JRLipina/PowerBoard-Hardware/2015/Hardware/PT_2015_PB_MAIN_Rev2_Panelization.brd

## EAGLE design 2015/Hardware/PT_2015_PB_MAIN_Rev2_Panelization.brd (2015-01-30)

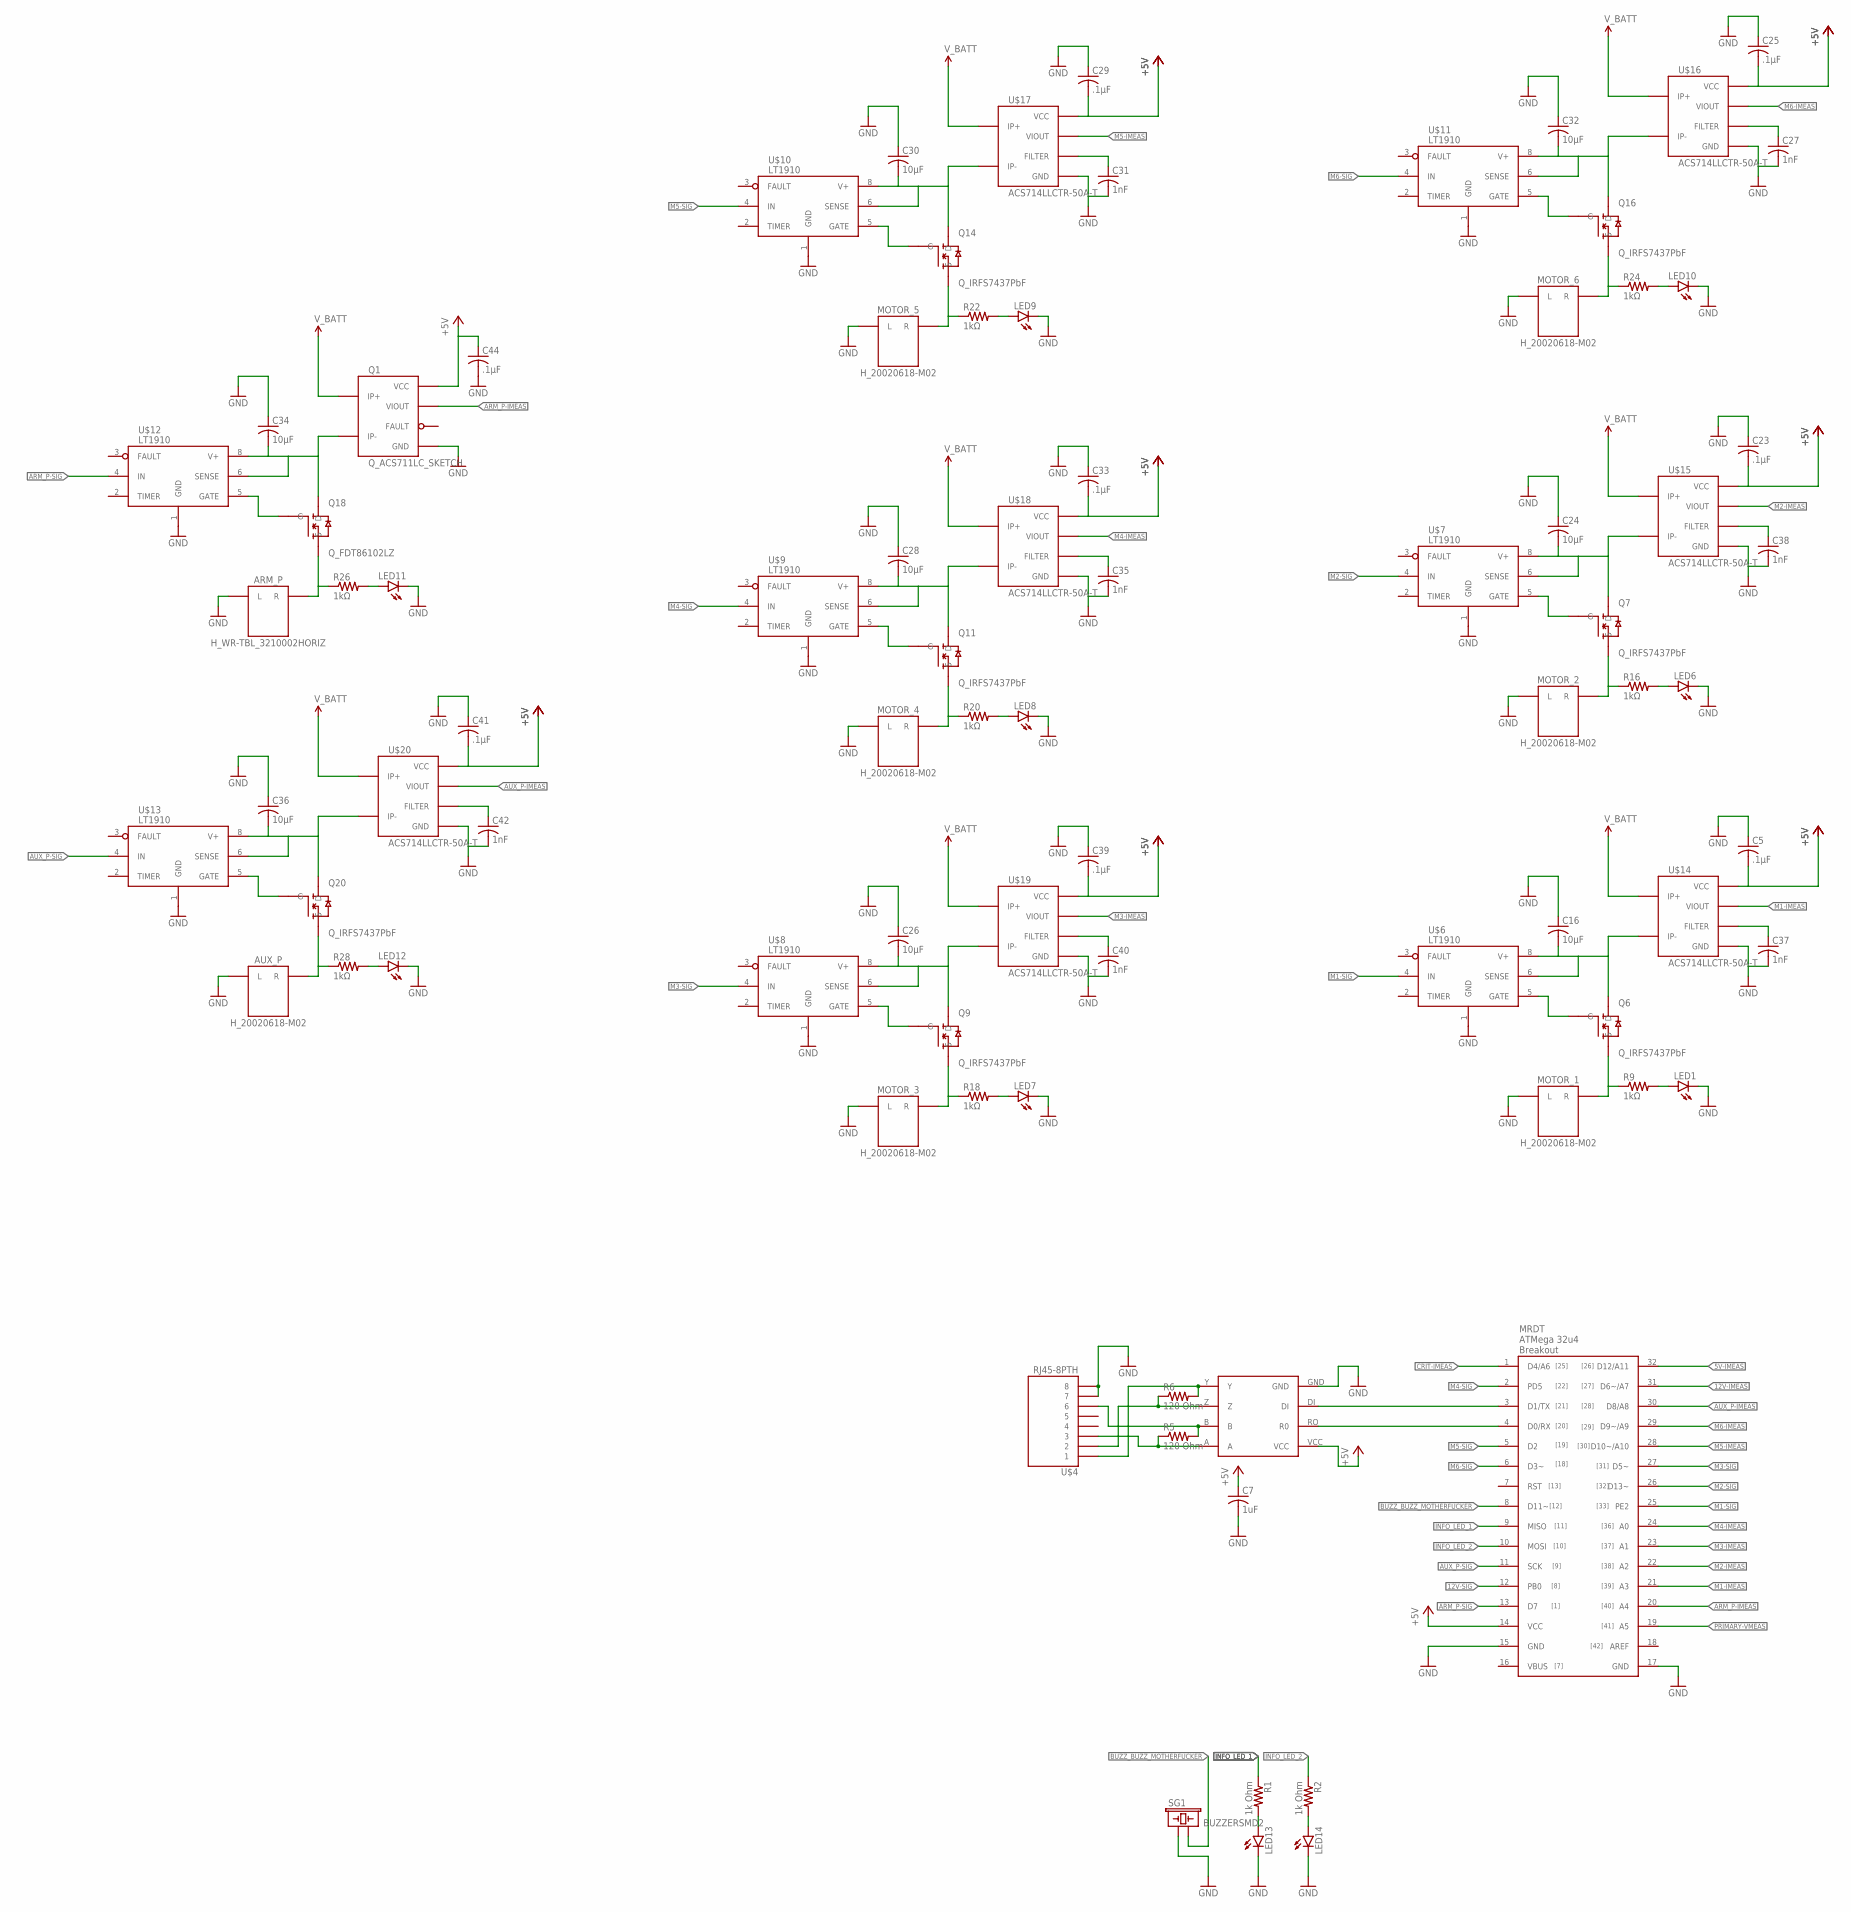
[picture p1: schematic PT_2015_PB_MAIN_Rev2_Panelization.sch, sheet 1, part in row 1, column 1]

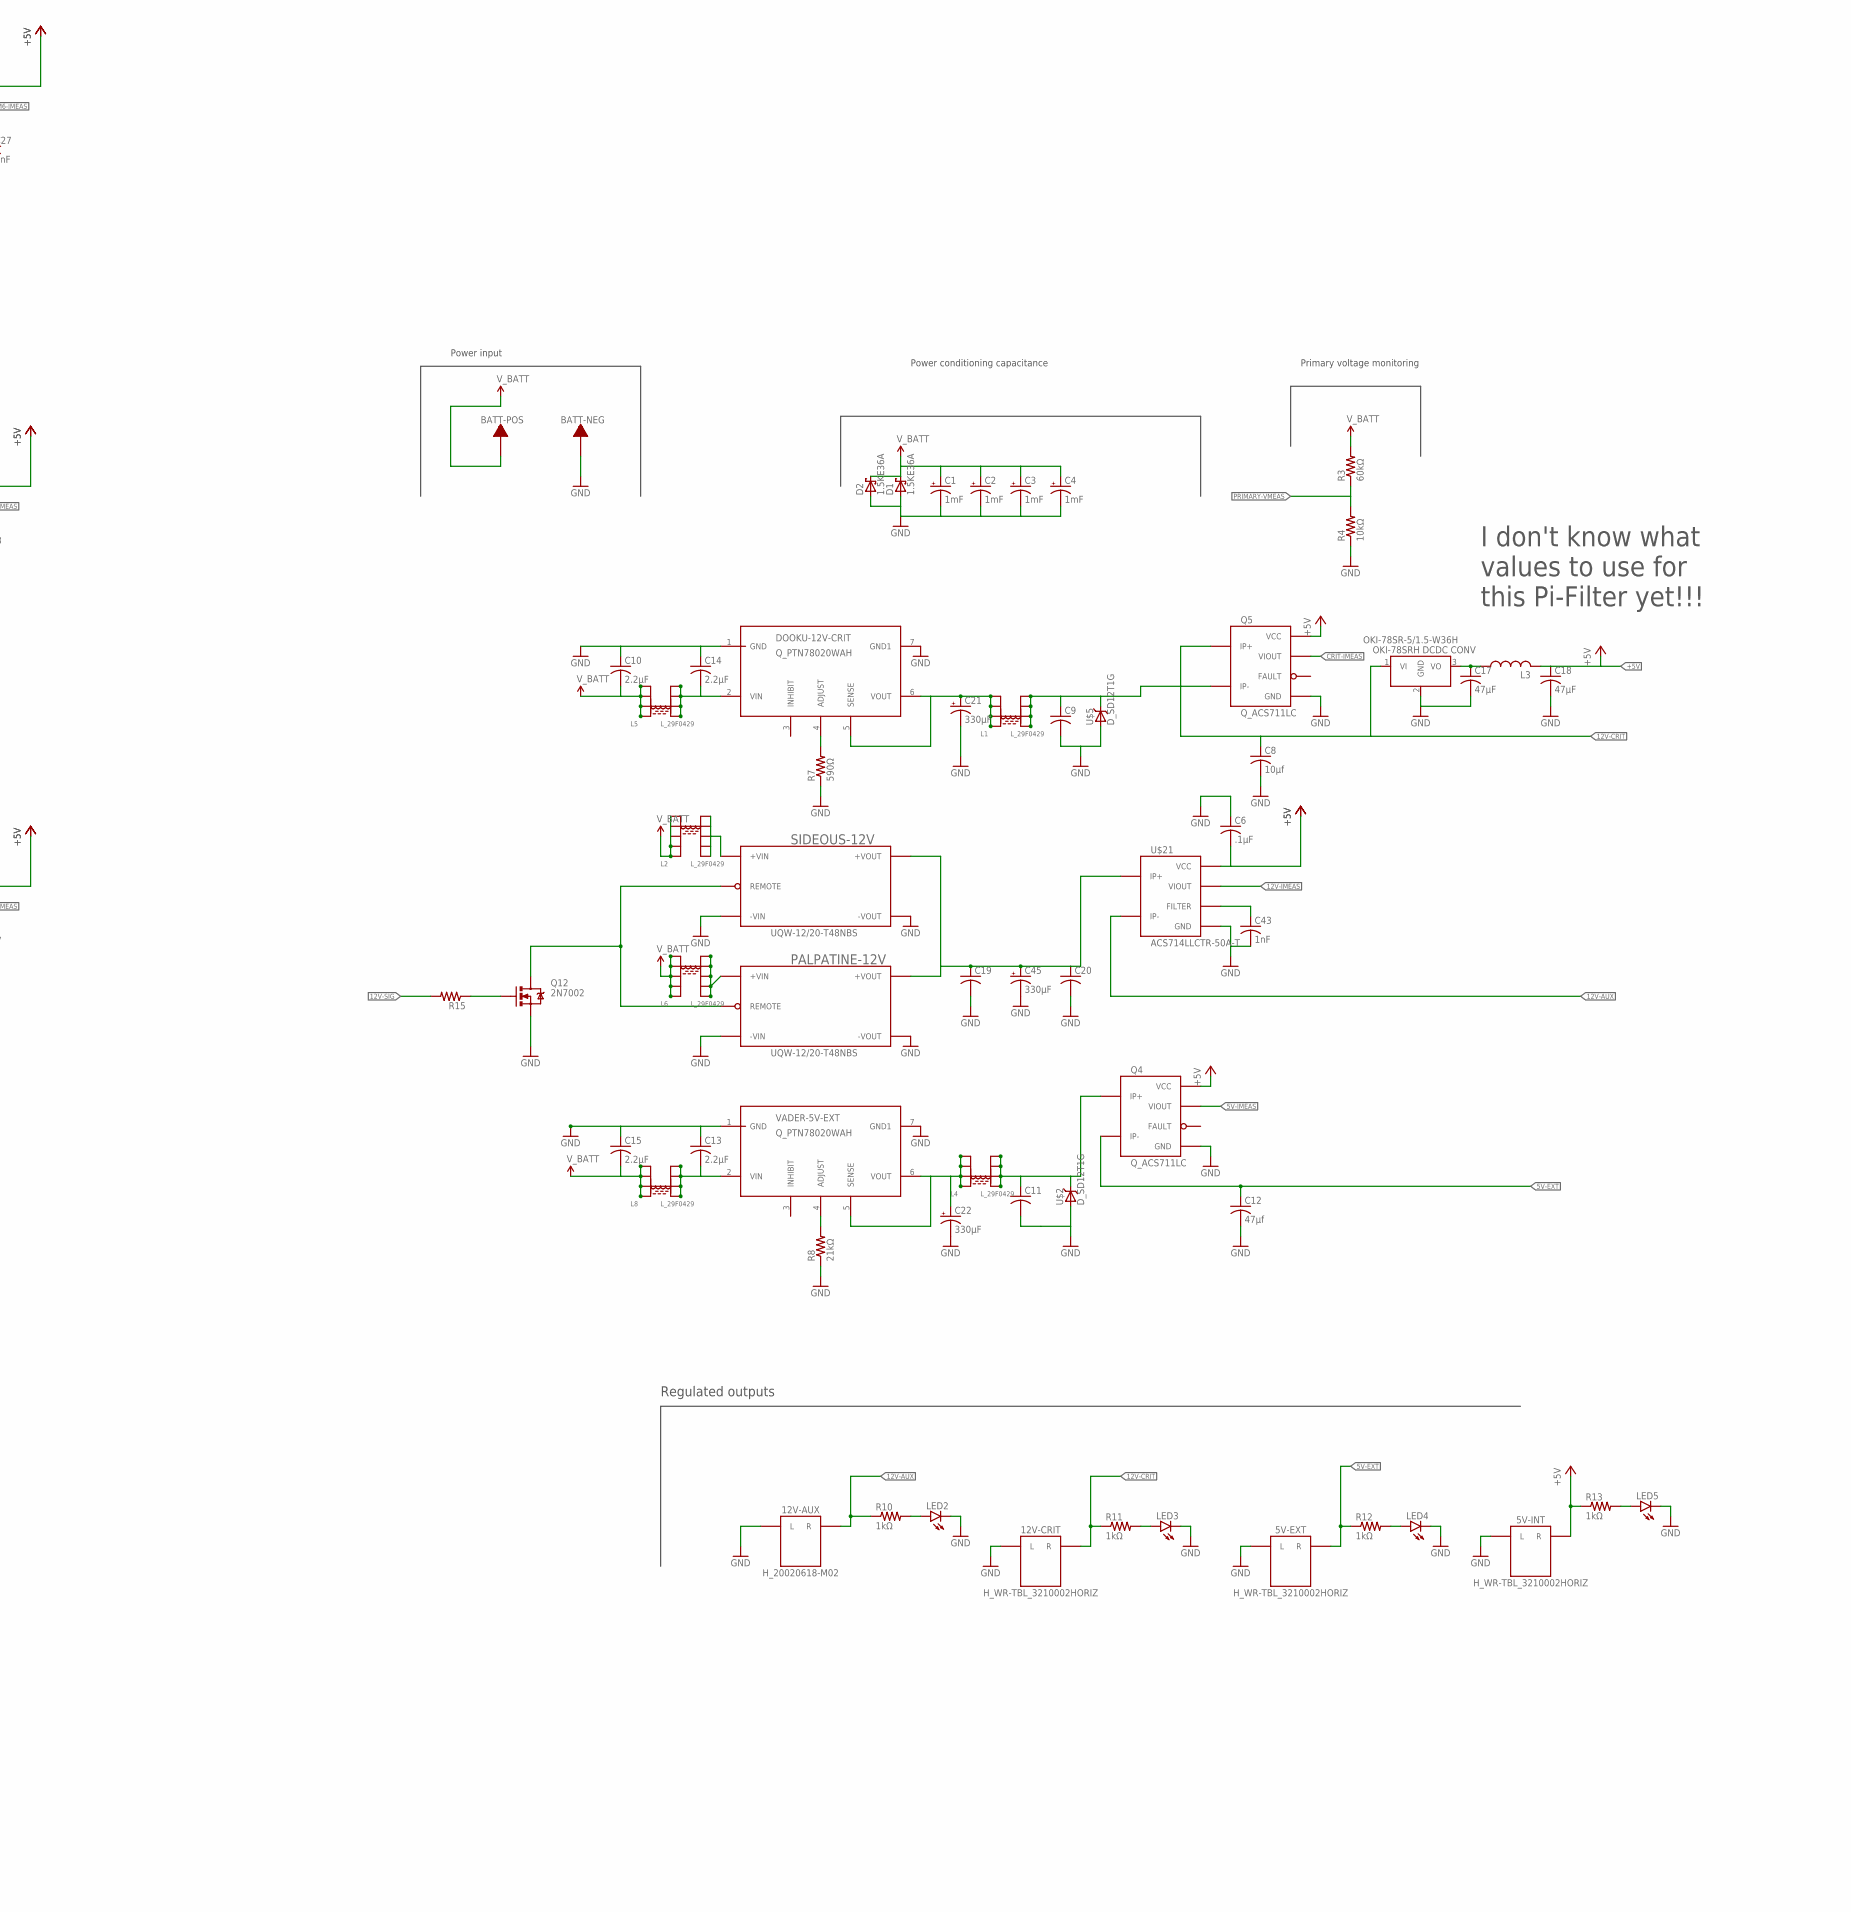
[picture p2: schematic PT_2015_PB_MAIN_Rev2_Panelization.sch, sheet 1, part in row 1, column 2]

Parts:
5V-EXT, 5V-INT, 12V-CRIT: H_WR-TBL_3210002HORIZ; 691322110002
12V-AUX: H_20020618-M02; 20020618-M02
ARM_P: H_WR-TBL_3210002HORIZ; 691322110002
AUX_P: H_20020618-M02; 20020618-M02
BATT-NEG: TERMINAL_HOLE; LARGE_TERMINAL_HOLE
BATT-POS: TERMINAL_HOLE; LARGE_TERMINAL_HOLE
C1, C2, C3, C4: 1mF; C_12.5MM
C5, C6, C23, C25, C29, C33, C39, C41, C44: .1µF; C1206
C7: 1uF; C1206
C8: 10µf; C1206
C9, C11, C19, C20: C-USC1206; C1206
C10, C13, C14, C15: 2.2µF; C1206
C12: 47µf; C1206
C16, C24, C26, C28, C30, C32, C34, C36: 10µF; C1206
C17, C18: 47µF; C1206
C21, C22, C45: 330µF; E5-8,5
C27, C31, C35, C37, C38, C40, C42, C43: 1nF; C0805
D1, D2: 1.5KE36A; CB429-17
DOOKU-12V-CRIT: Q_PTN78020WAH; R_PDSS-T7
L1, L4, L5, L8: L_29F0429
L2, L6: L_29F0429; L_29F0528
L3: L-USL4532C; L4532M
LED1, LED2, LED3, LED4, LED5, LED6, LED7, LED8, LED9, LED10, LED11, LED12: LED1206; LED-1206
LED13, LED14: LED-FKIT-1206; FKIT-LED-1206
MOTOR_1, MOTOR_2, MOTOR_3, MOTOR_4, MOTOR_5, MOTOR_6: H_20020618-M02; 20020618-M02
OKI-78SR-5/1.5-W36H: Q_OKI-78SR; OKI-78SRH
PALPATINE-12V: UQW-12/20-T48NBS; U-T48-QB-NO_TRIM
Q1: Q_ACS711LC_SKETCH; SOIC8_ACS711_SKETCH
Q4, Q5: Q_ACS711LC; SOIC8_ACS711
Q6, Q7, Q9, Q11, Q14, Q16, Q20: Q_IRFS7437PbF; D2PACK
Q12: 2N7002; SOT323
Q18: Q_FDT86102LZ; SOT-223
R1, R2: 1k Ohm; 1206
R3: 60kΩ; R1206
R4: 10kΩ; R1206
R5, R6: 120 Ohm; 1206
R7: 590Ω; R1206
R8: 21kΩ; R1206
R9, R10, R11, R12, R13, R16, R18, R20, R22, R24, R26, R28: 1kΩ; 1206
R15: R-US_R1206; R1206
SG1: BUZZERSMD2; BUZZER-CCV
SIDEOUS-12V: UQW-12/20-T48NBS; U-T48-QB-NO_TRIM
U$1: 32U4_BREAKOUT; 32U4_MCU_DIP
U$2, U$5: D_SD12T1G; SOD-323
U$3: MAX3077; MAX3070E
U$4: RJ45-8PTH; RJ45-8
U$6, U$7, U$8, U$9, U$10, U$11, U$12, U$13: LT1910; SO8
U$14, U$15, U$16, U$17, U$18, U$19, U$20: ACS714LLCTR-50A-T; SOIC8_ACS711_SKETCH
U$21: ACS714LLCTR-50A-T; SOIC8_ACS711
VADER-5V-EXT: Q_PTN78020WAH; R_PDSS-T7

Connections:
0: 5V-EXT.L, 5V-INT.L, 12V-AUX.L1 (L), 12V-AUX.L2 (L), 12V-CRIT.L, ARM_P.L, AUX_P.L1 (L), AUX_P.L2 (L), BATT-NEG.P$1, C1.-, C2.-, C3.-, C4.-, C5.1, C6.1, C7.2, C8.2, C9.2, C10.1, C11.2, C12.2, C13.1, C14.1, C15.1, C16.1, C17.2, C18.2, C19.2, C20.2, C21.-, C22.-, C23.1, C24.1, C25.1, C26.1, C27.2, C28.1, C29.1, C30.1, C31.2, C32.1, C33.1, C34.1, C35.2, C36.1, C37.2, C38.2, C39.1, C40.2, C41.1, C42.2, C43.2, C44.2, C45.-, D1.A, D2.A, DOOKU-12V-CRIT.1 (GND), DOOKU-12V-CRIT.7 (GND1), LED1.C, LED2.C, LED3.C, LED4.C, LED5.C, LED6.C, LED7.C, LED8.C, LED9.C, LED10.C, LED11.C, LED12.C, LED13.C, LED14.C, MOTOR_1.L1 (L), MOTOR_1.L2 (L), MOTOR_2.L1 (L), MOTOR_2.L2 (L), MOTOR_3.L1 (L), MOTOR_3.L2 (L), MOTOR_4.L1 (L), MOTOR_4.L2 (L), MOTOR_5.L1 (L), MOTOR_5.L2 (L), MOTOR_6.L1 (L), MOTOR_6.L2 (L), OKI-78SR-5/1.5-W36H.2 (GND), PALPATINE-12V.3 (-VIN), PALPATINE-12V.4 (-VOUT), Q1.5 (GND), Q4.5 (GND), Q5.5 (GND), Q12.2 (S), R4.1, R7.1, R8.1, SG1.+ (1), SIDEOUS-12V.3 (-VIN), SIDEOUS-12V.4 (-VOUT), U$1.15 (GND), U$1.17 (GND), U$2.2 (A), U$3.GND, U$4.7, U$4.8, U$5.2 (A), U$6.1 (GND), U$7.1 (GND), U$8.1 (GND), U$9.1 (GND), U$10.1 (GND), U$11.1 (GND), U$12.1 (GND), U$13.1 (GND), U$14.5 (GND), U$15.5 (GND), U$16.5 (GND), U$17.5 (GND), U$18.5 (GND), U$19.5 (GND), U$20.5 (GND), U$21.5 (GND), VADER-5V-EXT.1 (GND), VADER-5V-EXT.7 (GND1)
5V-EXT: 5V-EXT.R, C12.1, Q4.4 (IP-), R12.1
5V-IMEAS: Q4.7 (VIOUT), U$1.32 (D12/A11)
12V-AUX: 12V-AUX.R1 (R), 12V-AUX.R2 (R), R10.1, U$21.4 (IP-)
12V-CRIT: 12V-CRIT.R, C8.1, OKI-78SR-5/1.5-W36H.1 (VI), Q5.1 (IP+), R11.1
12V-IMEAS: U$1.31 (D6~/A7), U$21.7 (VIOUT)
12V-SIG: R15.2, U$1.12 (PB0)
+5V: 5V-INT.R, C5.2, C6.2, C7.1, C18.1, C23.2, C25.2, C29.2, C33.2, C39.2, C41.2, C44.1, L3.2, Q1.8 (VCC), Q4.8 (VCC), Q5.8 (VCC), R13.1, U$1.14 (VCC), U$3.VCC, U$14.8 (VCC), U$15.8 (VCC), U$16.8 (VCC), U$17.8 (VCC), U$18.8 (VCC), U$19.8 (VCC), U$20.8 (VCC), U$21.8 (VCC)
ARM_P-IMEAS: Q1.7 (VIOUT), U$1.20 (A4)
ARM_P-SIG: U$1.13 (D7), U$12.4 (IN)
AUX_P-IMEAS: U$1.30 (D8/A8), U$20.7 (VIOUT)
AUX_P-SIG: U$1.11 (SCK), U$13.4 (IN)
BUZZ_BUZZ_MOTHERFUCKER: SG1.- (2), U$1.8 (D11~)
CRIT-IMEAS: Q5.7 (VIOUT), U$1.1 (D4/A6)
INFO_LED_1: R1.1, U$1.9 (MISO)
INFO_LED_2: R2.1, U$1.10 (MOSI)
M1-IMEAS: U$1.21 (A3), U$14.7 (VIOUT)
M1-SIG: U$1.25 (PE2), U$6.4 (IN)
M2-IMEAS: U$1.22 (A2), U$15.7 (VIOUT)
M2-SIG: U$1.26 (D13~), U$7.4 (IN)
M3-IMEAS: U$1.23 (A1), U$19.7 (VIOUT)
M3-SIG: U$1.27 (D5~), U$8.4 (IN)
M4-IMEAS: U$1.24 (A0), U$18.7 (VIOUT)
M4-SIG: U$1.2 (PD5), U$9.4 (IN)
M5-IMEAS: U$1.28 (D10~/A10), U$17.7 (VIOUT)
M5-SIG: U$1.5 (D2), U$10.4 (IN)
M6-IMEAS: U$1.29 (D9~/A9), U$16.7 (VIOUT)
M6-SIG: U$1.6 (D3~), U$11.4 (IN)
unnamed: C37.1, U$14.6 (FILTER)
unnamed: C38.1, U$15.6 (FILTER)
unnamed: C13.2, L8.5, L8.6, L8.7, L8.8, VADER-5V-EXT.2 (VIN)
unnamed: PALPATINE-12V.2 (REMOTE), Q12.3 (D), SIDEOUS-12V.2 (REMOTE)
unnamed: L6.6, L6.7, L6.8, L6.9, L6.10, PALPATINE-12V.1 (+VIN)
unnamed: L2.6, L2.7, L2.8, L2.9, L2.10, SIDEOUS-12V.1 (+VIN)
unnamed: C19.1, C20.1, C45.+, PALPATINE-12V.8 (+VOUT), SIDEOUS-12V.8 (+VOUT), U$21.1 (IP+)
unnamed: C14.2, DOOKU-12V-CRIT.2 (VIN), L5.5, L5.6, L5.7, L5.8
unnamed: DOOKU-12V-CRIT.4 (ADJUST), R7.2
unnamed: C9.1, L1.5, L1.6, L1.7, L1.8, Q5.4 (IP-), U$5.1 (C)
unnamed: LED13.A, R1.2
unnamed: C43.1, U$21.6 (FILTER)
unnamed: R6.2, U$3.Y, U$4.1
unnamed: C22.+, L4.1, L4.2, L4.3, L4.4, VADER-5V-EXT.5 (SENSE), VADER-5V-EXT.6 (VOUT)
unnamed: C11.1, L4.5, L4.6, L4.7, L4.8, Q4.1 (IP+), U$2.1 (C)
unnamed: C27.1, U$16.6 (FILTER)
unnamed: R6.1, U$3.Z, U$4.2
unnamed: R5.2, U$3.B, U$4.6
unnamed: R5.1, U$3.A, U$4.3
unnamed: U$1.3 (D1/TX), U$3.DI
unnamed: C31.1, U$17.6 (FILTER)
unnamed: C35.1, U$18.6 (FILTER)
unnamed: C40.1, U$19.6 (FILTER)
unnamed: C42.1, U$20.6 (FILTER)
unnamed: C24.2, Q7.TAB (D), U$7.6 (SENSE), U$7.8 (V+), U$15.4 (IP-)
unnamed: MOTOR_2.R1 (R), MOTOR_2.R2 (R), Q7.2 (S), R16.1
unnamed: Q7.1 (G), U$7.5 (GATE)
unnamed: LED6.A, R16.2
unnamed: LED14.A, R2.2
unnamed: R8.2, VADER-5V-EXT.4 (ADJUST)
unnamed: C21.+, DOOKU-12V-CRIT.5 (SENSE), DOOKU-12V-CRIT.6 (VOUT), L1.1, L1.2, L1.3, L1.4
unnamed: LED1.A, R9.2
unnamed: C16.2, Q6.TAB (D), U$6.6 (SENSE), U$6.8 (V+), U$14.4 (IP-)
unnamed: MOTOR_1.R1 (R), MOTOR_1.R2 (R), Q6.2 (S), R9.1
unnamed: Q6.1 (G), U$6.5 (GATE)
unnamed: C26.2, Q9.TAB (D), U$8.6 (SENSE), U$8.8 (V+), U$19.4 (IP-)
unnamed: MOTOR_3.R1 (R), MOTOR_3.R2 (R), Q9.2 (S), R18.1
unnamed: LED2.A, R10.2
unnamed: Q9.1 (G), U$8.5 (GATE)
unnamed: LED3.A, R11.2
unnamed: LED7.A, R18.2
unnamed: LED4.A, R12.2
unnamed: LED5.A, R13.2
unnamed: C28.2, Q11.TAB (D), U$9.6 (SENSE), U$9.8 (V+), U$18.4 (IP-)
unnamed: MOTOR_4.R1 (R), MOTOR_4.R2 (R), Q11.2 (S), R20.1
unnamed: Q11.1 (G), U$9.5 (GATE)
unnamed: LED8.A, R20.2
unnamed: C30.2, Q14.TAB (D), U$10.6 (SENSE), U$10.8 (V+), U$17.4 (IP-)
unnamed: MOTOR_5.R1 (R), MOTOR_5.R2 (R), Q14.2 (S), R22.1
unnamed: Q14.1 (G), U$10.5 (GATE)
unnamed: LED9.A, R22.2
unnamed: C32.2, Q16.TAB (D), U$11.6 (SENSE), U$11.8 (V+), U$16.4 (IP-)
unnamed: MOTOR_6.R1 (R), MOTOR_6.R2 (R), Q16.2 (S), R24.1
unnamed: Q16.1 (G), U$11.5 (GATE)
unnamed: LED10.A, R24.2
unnamed: C34.2, Q1.4 (IP-), Q18.2 (D), Q18.4 (D), U$12.6 (SENSE), U$12.8 (V+)
unnamed: ARM_P.R, Q18.3 (S), R26.1
unnamed: Q18.1 (G), U$12.5 (GATE)
unnamed: LED11.A, R26.2
unnamed: C36.2, Q20.TAB (D), U$13.6 (SENSE), U$13.8 (V+), U$20.4 (IP-)
unnamed: AUX_P.R1 (R), AUX_P.R2 (R), Q20.2 (S), R28.1
unnamed: Q20.1 (G), U$13.5 (GATE)
unnamed: LED12.A, R28.2
unnamed: C17.1, L3.1, OKI-78SR-5/1.5-W36H.3 (VO)
unnamed: Q12.1 (G), R15.1
PRIMARY-VMEAS: R3.1, R4.2, U$1.19 (A5)
RXD: U$1.4 (D0/RX), U$3.RO (R0)
V_BATT: BATT-POS.P$1, C1.+, C2.+, C3.+, C4.+, C10.2, C15.2, D1.C, D2.C, L2.1, L2.2, L2.3, L2.4, L2.5, L5.1, L5.2, L5.3, L5.4, L6.1, L6.2, L6.3, L6.4, L6.5, L8.1, L8.2, L8.3, L8.4, Q1.1 (IP+), R3.2, U$14.1 (IP+), U$15.1 (IP+), U$16.1 (IP+), U$17.1 (IP+), U$18.1 (IP+), U$19.1 (IP+), U$20.1 (IP+)

Notes on the sheet:
Primary voltage monitoring
Power conditioning capacitance
Power input
I don't know what values to use for this Pi-Filter yet!!!
Regulated outputs

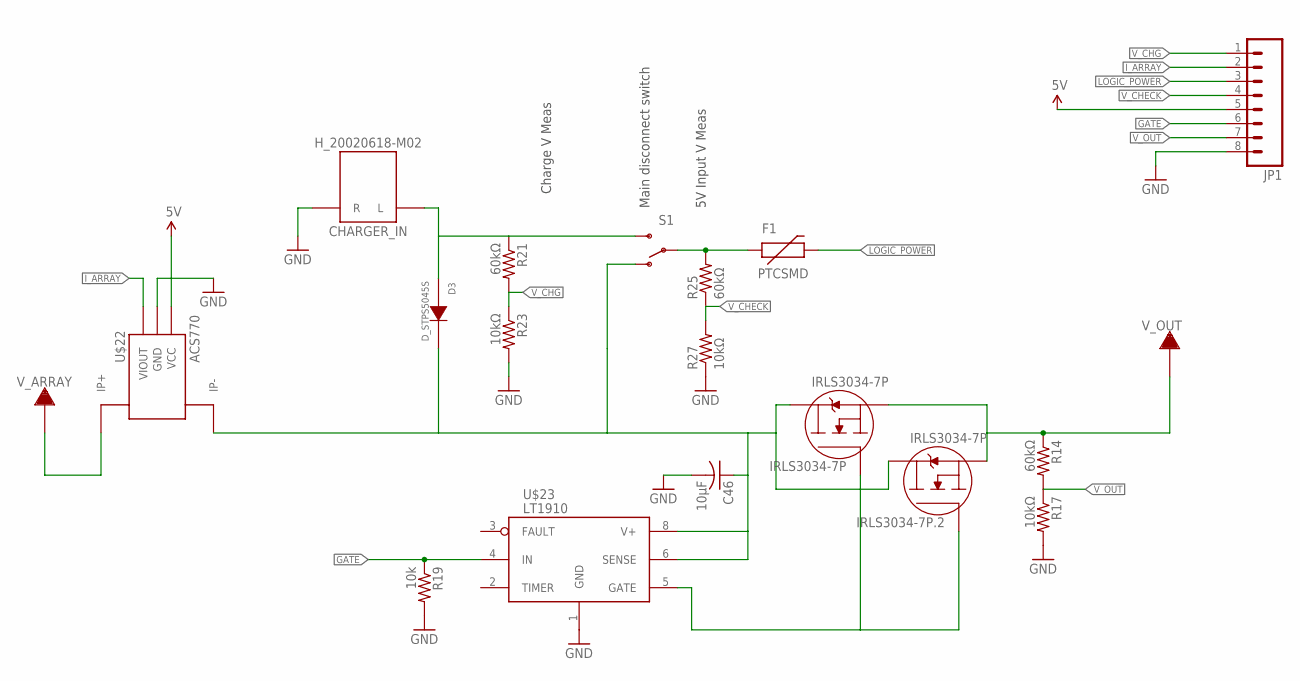
[picture p3: schematic PT_2015_PB_MAIN_Rev2_Panelization.sch, sheet 2]

Parts:
C46: 10µF; C1206
CHARGER_IN: H_20020618-M02; 20020618-M02
D3: D_STPS5045S; D2PACK
F1: PTCSMD; PTC-1206
IRLS3034-7P, IRLS3034-7P.2: IRLS3034-7P; D2PAK-7
JP1: M08BM08B-SRSS-TB; BM08B-SRSS-TB
R14, R21, R25: 60kΩ; R1206
R17, R23, R27: 10kΩ; R1206
R19: 10k; R1206
S1: SWITCH-SPDTPTH; SWITCH-SPDT
U$22: ACS770; PFF_LEADFORM
U$23: LT1910; SO8
V_ARRAY: TERMINAL_HOLE; LARGE_TERMINAL_HOLE
V_OUT: TERMINAL_HOLE; LARGE_TERMINAL_HOLE

Connections:
5V_SSR: JP1.5, U$22.1 (VCC)
GATE: JP1.6, R19.1, U$23.4 (IN)
GND_SSR: C46.2, CHARGER_IN.R1 (R), CHARGER_IN.R2 (R), JP1.8, R17.2, R19.2, R23.2, R27.1, U$22.2 (GND), U$23.1 (GND)
I_ARRAY: JP1.2, U$22.3 (VIOUT)
LOGIC_POWER: F1.2, JP1.3
unnamed: IRLS3034-7P.2 (SOURCE), IRLS3034-7P.3 (SOURCE), IRLS3034-7P.4 (SOURCE), IRLS3034-7P.5 (SOURCE), IRLS3034-7P.6 (SOURCE), IRLS3034-7P.2.2 (SOURCE), IRLS3034-7P.2.3 (SOURCE), IRLS3034-7P.2.4 (SOURCE), IRLS3034-7P.2.5 (SOURCE), IRLS3034-7P.2.6 (SOURCE), R14.1, V_OUT.P$1
unnamed: IRLS3034-7P.1 (GATE), IRLS3034-7P.2.1 (GATE), U$23.5 (GATE)
unnamed: U$22.4_1 (IP+), U$22.4_2 (IP+), U$22.4_3 (IP+), U$22.4_4 (IP+), U$22.4_5 (IP+), U$22.4_6 (IP+), U$22.4_7 (IP+), U$22.4_8 (IP+), U$22.4_9 (IP+), U$22.4_10 (IP+), U$22.4_11 (IP+), U$22.4_12 (IP+), U$22.4_13 (IP+), U$22.4_14 (IP+), U$22.4_15 (IP+), U$22.4_16 (IP+), U$22.4_B (IP+), U$22.4_T (IP+), V_ARRAY.P$1
unnamed: C46.1, D3.TAB (K), IRLS3034-7P.PAD (DRAIN), IRLS3034-7P.2.PAD (DRAIN), S1.1 (O), U$22.5_1 (IP-), U$22.5_2 (IP-), U$22.5_3 (IP-), U$22.5_4 (IP-), U$22.5_5 (IP-), U$22.5_6 (IP-), U$22.5_7 (IP-), U$22.5_8 (IP-), U$22.5_9 (IP-), U$22.5_10 (IP-), U$22.5_11 (IP-), U$22.5_12 (IP-), U$22.5_13 (IP-), U$22.5_14 (IP-), U$22.5_15 (IP-), U$22.5_16 (IP-), U$22.5_B (IP-), U$22.5_T (IP-), U$23.6 (SENSE), U$23.8 (V+)
unnamed: CHARGER_IN.L1 (L), CHARGER_IN.L2 (L), D3.1 (A), D3.2 (A), R21.1, S1.3 (S)
unnamed: F1.1, R25.2, S1.2
V_CHECK: JP1.4, R25.1, R27.2
V_CHG: JP1.1, R21.2, R23.1
V_OUT: JP1.7, R14.2, R17.1

Notes on the sheet:
Charge V Meas
5V Input V Meas
Main disconnect switch

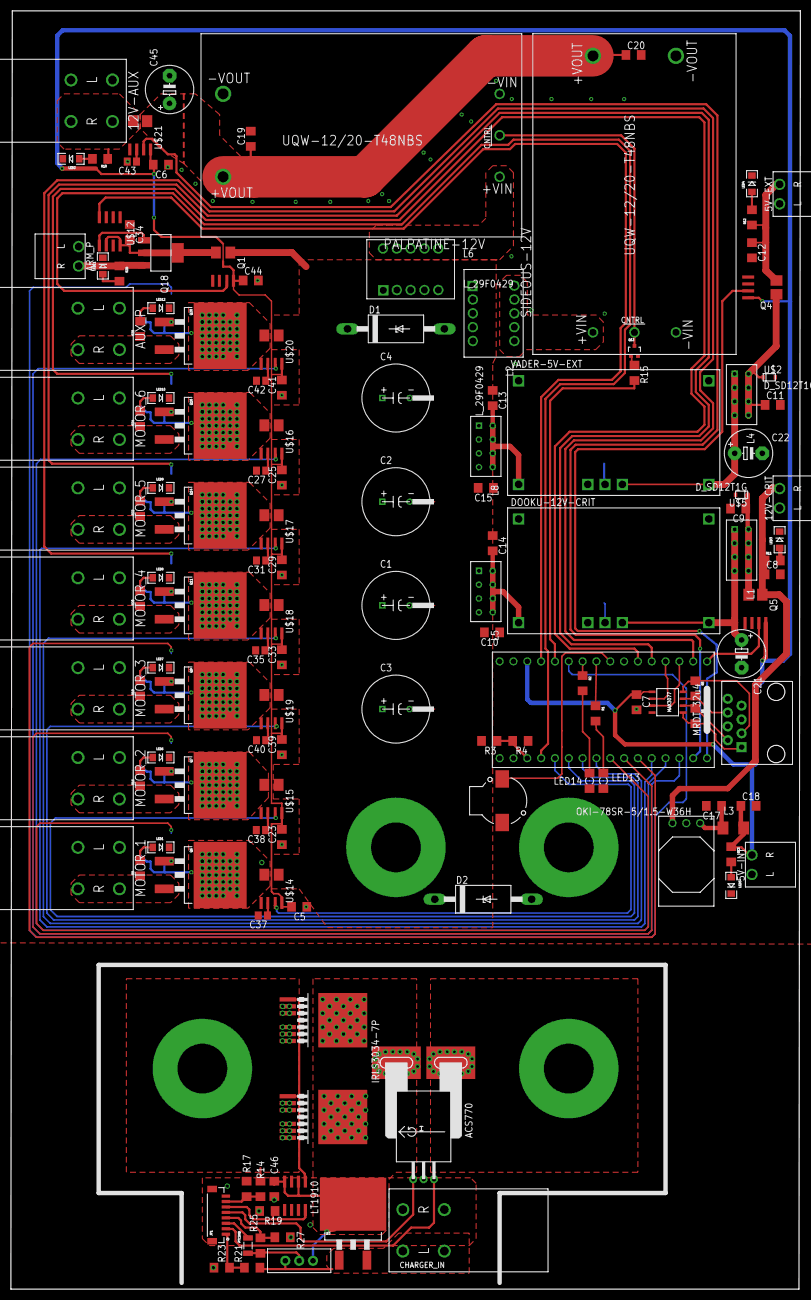
[picture p4: board PT_2015_PB_MAIN_Rev2_Panelization.brd from above]

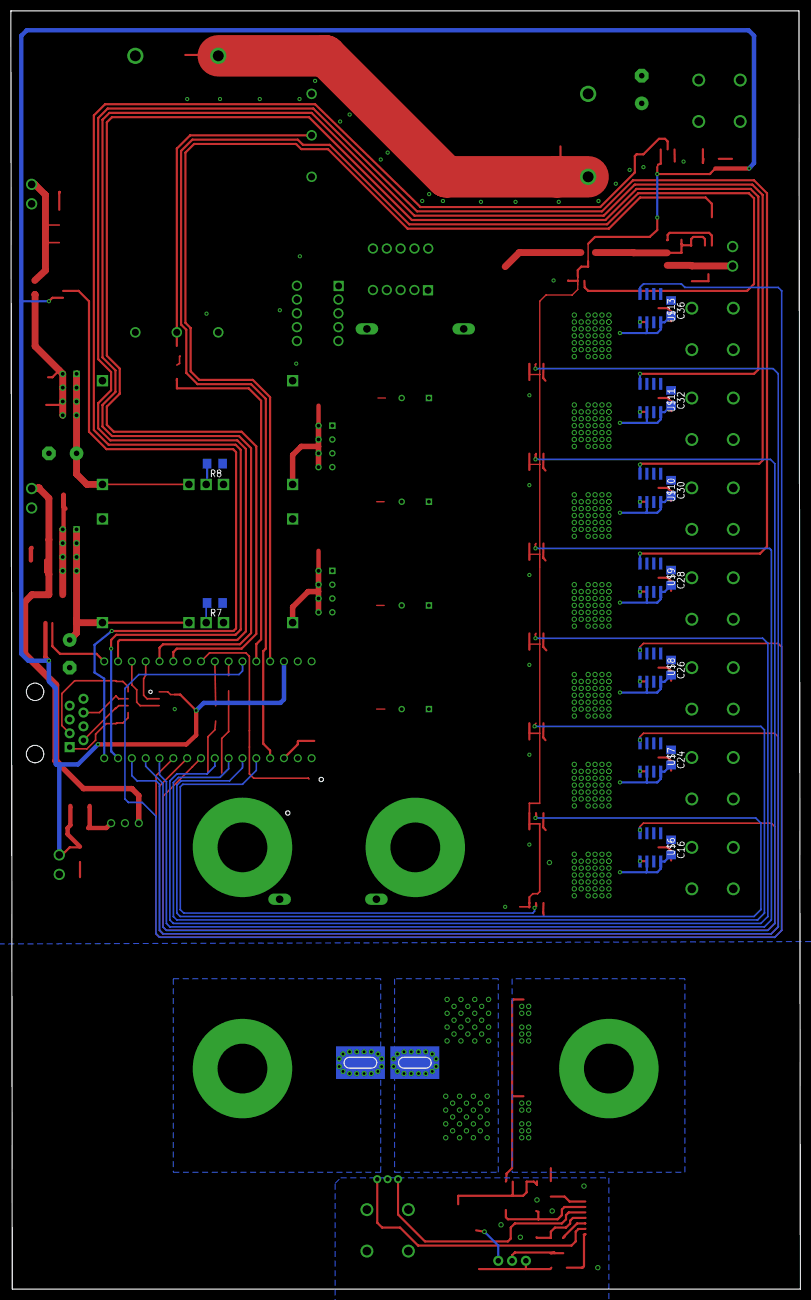
[picture p5: board PT_2015_PB_MAIN_Rev2_Panelization.brd from below]

Board: 2 copper layers, 145.0 x 234.8 mm, 161 parts (16 on the bottom side), 110 nets.
