JRLipina/PowerBoard-Hardware/2015/ATmega32u4 Breakout/32u4 board.brd

## EAGLE design 2015/ATmega32u4 Breakout/32u4 board.brd (2014-12-17)

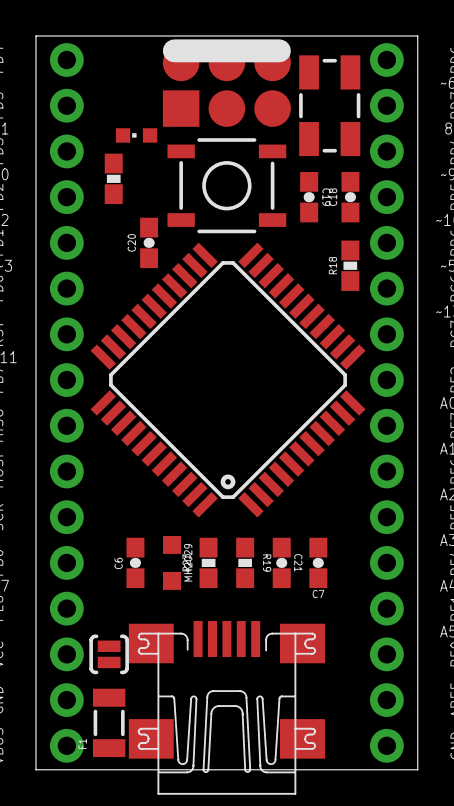
[picture p6: board 32u4 board.brd from above]

Board: 2 copper layers, 21.2 x 40.8 mm, 21 parts (0 on the bottom side), 41 nets, no tracks yet.

Parts:
C6: 1uF; 0603-CAP
C7: 1.0uF; 0603-CAP
C18, C19: 18pF; 0603-CAP
C20, C21: 0.1uF; 0603-CAP
F1: PTCSMD; PTC-1206
JP1, JP2: M161X16_NO_SILK; 1X16_NO_SILK
LED1: CHIPLED_0603
MH2029: MH2029-300Y; L2012C
R1: 1k; 0603-RES
R18: 10k; 0603-RES
R19, R23: 22; 0603-RES
S1: SWITCH-MOMENTARY-2SMD; TACTILE_SWITCH_SMD
SJ1: SOLDERJUMPERNO; SJ_2S-NO
U$2: ICSP_SMD; ICSP
U$3: ATMEGA32U4TQFP-44; TQFP44
U$4: CRYSTAL-GROUNDED; CRYSTAL-SMD-5X3
X1: MINI-USB-UX60A-MB-5ST; UX60A-MB-5ST

Connections:
AREF: C21.1, JP1.15, U$3.42
D+: R19.2, X1.3
D-: R23.2, X1.2
GND: C6.2, C7.2, C18.2, C19.2, C20.2, C21.2, JP1.16, JP2.2, R1.1, S1.1, U$2.3, U$3.5, U$3.15, U$3.23, U$3.35, U$3.43, U$4.2, U$4.4, X1.5
MISO: JP2.8, U$2.6, U$3.11
MOSI: JP2.7, U$2.2, U$3.10
unnamed: LED1.C, R1.2
unnamed: F1.2, X1.1
unnamed: R19.1, U$3.4
unnamed: R23.1, U$3.3
unnamed: C6.1, U$3.6
unnamed: C20.1, MH2029.1, U$3.24, U$3.44
unnamed: C19.1, U$3.17, U$4.3
unnamed: C18.1, U$3.16, U$4.1
PB0: JP2.5, U$3.8
PB4: JP1.3, U$3.28
PB5: JP1.4, U$3.29
PB6: JP1.5, U$3.30
PB7: JP2.9, U$3.12
PC6: JP1.6, U$3.31
PC7: JP1.7, U$3.32
PD0: JP2.11, U$3.18
PD1: JP2.12, U$3.19
PD2: JP2.13, U$3.20
PD3: JP2.14, U$3.21
PD4: JP2.16, U$3.25
PD5: JP2.15, U$3.22
PD6: JP1.1, U$3.26
PD7: JP1.2, U$3.27
PE2: JP1.8, U$3.33
PE6: JP2.4, U$3.1
PF0: JP1.14, U$3.41
PF1: JP1.13, U$3.40
PF4: JP1.12, U$3.39
PF5: JP1.11, U$3.38
PF6: JP1.10, U$3.37
PF7: JP1.9, U$3.36
RST: JP2.10, R18.1, S1.3, U$2.4, U$3.13
SCK: JP2.6, U$2.5, U$3.9
VBUS: C7.1, F1.1, JP2.1, SJ1.1, U$3.7
VCC: JP2.3, LED1.A, MH2029.2, R18.2, SJ1.2, U$2.1, U$3.2, U$3.14, U$3.34
