JRLipina/PowerBoard-Hardware/(commit log)

2014-11-07 Initial commit of first reroute attempt
    moving small ICs and other components to board underside
    [PT_2015_PB_MAIN_Rev1.brd]
2014-11-11 dlkgsdkjghsa
    khsighdlka
    [PT_2015_PB_MAIN_Rev1.brd]
2014-11-11 i did things
    many things
    [PT_2015_PB_MAIN_Rev1.brd]
2014-11-11 i did literally nothing
    yeah
    [PT_2015_PB_MAIN_Rev1.brd]
2014-12-09 Added Digikey PN for C41
    duh.
    [PT_2015_PB_MAIN_Rev2.brd, PT_2015_PB_MAIN_Rev2.sch]
2014-12-17 Started adding Castellated Edges
    http://lmgtfy.com/?q=Castellated+Edges
    [32u4 board.brd]
2015-01-27 Soldermask removed
    high current traces now have soldermask removed to thicken with solder
    for higher current capability. Must be coated with solder mask or tape
    after soldering. Need to check/verify doing this under the board mount
    connectors, diode, and caps using 1oz board - recommend using this
    revision to purchase 1oz board for testing. Final version will be 2oz.
    [PT_2015_PB_MAIN_Rev2.brd, PT_2015_PB_MAIN_Rev2.sch]
2015-01-28 Frankensteined the two boards together. I am hoping to save money by only ordering one board and making the cut ourselves.
    [PT_2015_PB_MAIN_Rev2_Panelization.brd, PT_2015_PB_MAIN_Rev2_Panelization.sch]
2015-01-28 Spaced out the boards to make it easier to cut.
    [PT_2015_PB_MAIN_Rev2_Panelization.brd]
2015-01-28 Fixed all of the FreeDFM errors. The Panelized board should be ready to order. I will confirm tonight and tomorrow, but the idea is that we will cut the SSR board out of the Power Board to save a ton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
    [PT_2015_PB_MAIN_Rev2_Panelization.brd]
2015-01-28 Fixed the Ferrite Bead Footprint
    [PT_2015_PB_MAIN_Rev2_Panelization.brd, PT_2015_PB_MAIN_Rev2_Panelization.sch]
2015-01-28 Fixed the TSTOP to prevent shorts.
    [PT_2015_PB_MAIN_Rev2_Panelization.brd]
2015-01-28 Deleted Extraneous BOM Files
    [BOM_Rev_2.xls, BOM_Rev_2.xlsx, PT_2015_PB_MAIN_Rev2_BOM.csv]
2015-01-28 Cleaned up my idiotic TSTOP
    [PT_2015_PB_MAIN_Rev2_Panelization.brd]
2015-01-28 Fixed the connector on SSR portion
    [PT_2015_PB_MAIN_Rev2_Panelization.brd, PT_2015_PB_MAIN_Rev2_Panelization.sch]
2015-01-29 Switched out the SSR to meet 3oz Spec
    [PT_2015_PB_MAIN_Rev2_Panelization.brd, PT_2015_PB_MAIN_Rev2_Panelization.sch]
2015-01-29 Fixed DRC Errors
    [PT_2015_PB_MAIN_Rev2_Panelization.brd]
2015-01-30 Pushing the Final SSR/PowerBoard
    [PT_2015_PB_MAIN_Rev2_Panelization.brd]
